itpcc/Poor-man-NeoPixel-board/Hardwares/BOM.csv

ID | Name | Designator | Footprint | Quantity | Manufacturer Part | Manufacturer | Supplier | Supplier Part | Notes
1 | FTDI_DEVICE | JP1 | FTDI_DEVICE_SIDE | 1 |  |  |  |  | Just 6 ports female pin headers should be enough.
2 | ESP8266-12E/ESP-12E | U1 | LGA22-2.0-24X16MM | 1 | ESP8266-12E/ESP-12E |  |  |  | Main (and only) processor
3 | JUMPER | JP2 | NONE | 1 |  |  |  |  | Or switch if you want
4 | USB-AF-90-10X14.4-H6.57 | USB1 | USB-AF-90-10.0X14.4-H6.57 | 1 | USB-AF-90-10X14.4-H6.57 | LCSC | LCSC | C39429 | Micro USB port?
5 | EVQ22705R | SW1 | KEY-6.0*6.0-4 | 1 | EVQ22705R | PANASONIC | LCSC | C79156 | SPST switch for "EN" (and "RESET")
6 | 2N7000 | Q1 | TO-92(TO-92-3) | 1 | 2N7000 | CJ | LCSC | C9114 | Level shifter MOSFET
7 | 1k | R1 | AXIAL-0.3 | 1 |  |  |  |  | Voltage divider
8 | 2k | R2 | AXIAL-0.3 | 1 |  |  |  |  | Voltage divider
9 | 1000u | C1 | CAP-D3.0XF1.5 | 1 |  |  |  |  | Voltage spike reservoir
10 | 400 | R3 | AXIAL-0.3 | 1 |  |  |  |  | NeoPixel's data pin current limiting resistor
11 | 10k | R4 | AXIAL-0.3 | 1 |  |  |  |  | Pull-up resistor
12 | WJ2EDGVC-5.08-3P | P1 | WJ2EDGVC-5.08-3P | 1 | WJ2EDGVC-5.08-3P | ReliaPro | LCSC | C8430 | Socket to NeoPixels
