itpcc/Poor-man-NeoPixel-board/Hardwares/Schematic.pdf

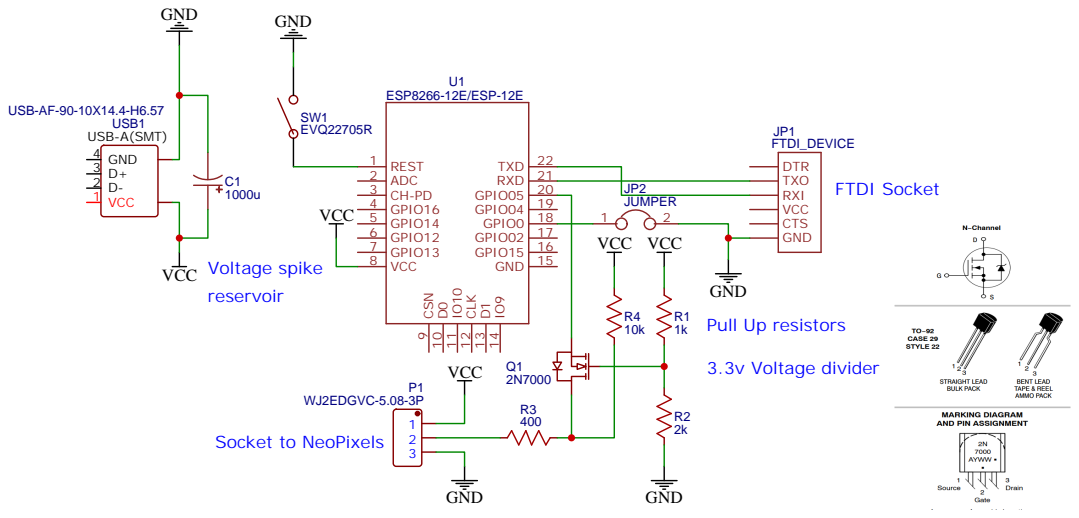
[picture p4: page 1]
